mfsurvilo/MotorController-PCB/Version Updates.txt

Version Tracking

V5.0 -	Updated footprints, Reduced Mounting hole sizes
	Used io pins to ground the power indicator lights.
	Reduced pad size for AC in 
V5.1 - 7/24 
	Placed parts, deleted pin break to pins . 
	Routed alt pins from TRS jack into MCU for future iteration. 
	Decreased board size. Changed footprint of motor connector to have holes.  
	Started routing 
	
V5.2 - 8/10
	Moved a few parts.
	Updated the footprint on the 5V PS
	Rearranged text and resized it.
