mfsurvilo/MotorController-PCB/Motor Controller V.5.2.brd

## EAGLE design Motor Controller V.5.2.brd (2021-08-20)

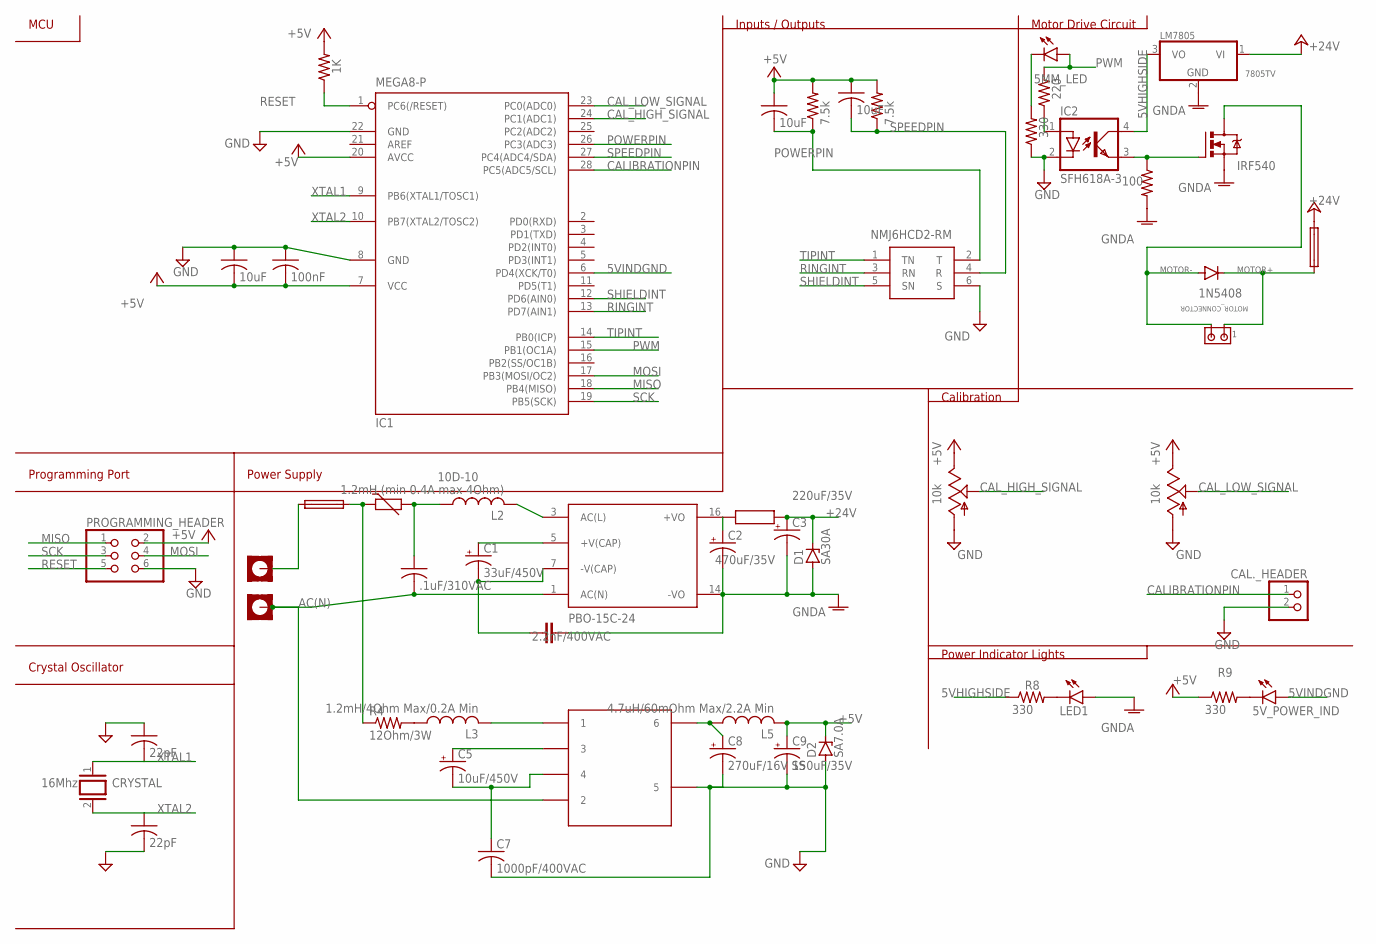
[picture p1: schematic Motor Controller V.5.2.sch]

Parts:
5V_POWER_IND: LED3MM
AC(N): PAD3.0; 3,0-PAD-SQUARE
C1: 33uF/450V; E5-13
C2: 470uF/35V; E5-10,5; MPN ECA1VHG471B
C3: 220uF/35V; E5-10,5; MPN A768KS227M1VLAE024
C4: .1uF/310VAC; C102-064X133
C5: 10uF/450V; E5-10,5
C6, C15: 22pF; C025-024X044
C7: 1000pF/400VAC; C075-052X106
C8: 270uF/16V SS; E2,5-6
C9: 150uF/35V; E3,5-8
C10, C12, C13: 10uF; C025-024X044
C14: 100nF; C025-024X044
CAL._HEADER: PINHD-1X2; 1X02
CRYSTAL: 16Mhz; QS
CY1: 2.2nF/400VAC; YC10B4
D1: SA30A; TVS-10
D2: SA7.0A; TVS-10
D3: 1N5408; DO201-15; MPN 1N5408-E3/54
F1: FUSESH22,5; SH22,5
F2: 1A/300V; SH22,5
FAST: 10k; CT6
H1: PAD3.0; 3,0-PAD-SQUARE
IC1: MEGA8-P; DIL28-3
IC2: SFH618A-3; DIP4
J1: NMJ6HCD2-RM; NMJ6HCD2RM
L2: 1.2mH (min 0.4A max 4Ohm); RCP1317_INDUCTOR
L3: 1.2mH/4Ohm Max/0.2A Min; RCP1317_INDUCTOR
L5: 4.7uH/60mOhm Max/2.2A Min; RLB0914_INDUCTOR
LED1: LED3MM
LM7805: 7805TV; TO220V
MOTOR_CONNECTOR: MATE-N-LOK_193839-1; MATE-N-LOK_2PIN_CONNECTOR
PROGRAMMING_HEADER: PINHD-2X3; 2X03
PS1: PBO-15C-24; CONV_PBO-15C-24
PWM_IND: 5MM_LED
Q1: IRF540; TO220BV
R1: 10D-10; R-7,5
R2: 1K; 0204/7
R3, R7: 7.5k; 0204/7
R4: 12Ohm/3W; VTA52
R5: 220; 0204/7
R6: 100; 0204/7
R8, R9, R10: 330; 0204/7
SLOW: 10k; CT6
U$1: L503-13B05R; LS03-13BO5R3
U$2: HCTI-22-16.4

Connections:
5VHIGHSIDE: IC2.4 (COL), LM7805.3 (VO), R8.1
5VINDGND: 5V_POWER_IND.A, IC1.6 (PD4(XCK/T0))
+5V: C9.+, C10.1, C12.1, C13.2, C14.2, D2.C, FAST.E, IC1.7 (VCC), IC1.20 (AVCC), L5.P$2 (2), PROGRAMMING_HEADER.2, R2.2, R3.2, R7.2, R9.1, SLOW.E
+24V: C3.+, D1.C, F1.2, LM7805.1 (VI), U$2.P$2
AC(L): L2.P$2 (2), PS1.3 (AC(L))
AC(N): AC(N).B3,0, C4.2, PS1.1 (AC(N)), U$1.3 (2), U$1.4 (2)
CALIBRATIONPIN: CAL._HEADER.1, IC1.28 (PC5(ADC5/SCL))
CAL_HIGH_SIGNAL: FAST.S, IC1.24 (PC1(ADC1))
CAL_LOW_SIGNAL: IC1.23 (PC0(ADC0)), SLOW.S
GND: C6.2, C7.2, C8.-, C9.-, C13.1, C14.1, C15.1, CAL._HEADER.2, D2.A, FAST.A, IC1.8 (GND), IC1.22 (GND), IC2.2 (C), J1.6 (S), PROGRAMMING_HEADER.6, R10.1, SLOW.A, U$1.9 (5), U$1.10 (5)
GNDA: C2.-, C3.-, CY1.1, D1.A, LED1.A, LM7805.2 (GND), PS1.14 (-VO), Q1.S, R6.2
MISO: IC1.18 (PB4(MISO)), PROGRAMMING_HEADER.1
MOSI: IC1.17 (PB3(MOSI/OC2)), PROGRAMMING_HEADER.4
MOTOR+: D3.C, F1.1, MOTOR_CONNECTOR.P$1 (1)
MOTOR-: D3.A, MOTOR_CONNECTOR.P$2 (2), Q1.D
unnamed: IC2.1 (A), R5.1
unnamed: IC2.3 (EMIT), Q1.G, R6.1
unnamed: LED1.K (C), R8.2
unnamed: C2.+, PS1.16 (+VO), U$2.P$1
unnamed: C1.+, PS1.5 (+V(CAP))
unnamed: C1.-, CY1.2, PS1.7 (-V(CAP))
unnamed: F2.2, H1.B3,0
unnamed: F2.1, R1.1, R4.1
unnamed: C4.1, L2.P$1 (1), R1.2
unnamed: 5V_POWER_IND.K (C), R9.2
unnamed: L3.P$1 (1), R4.2
unnamed: L3.P$2 (2), U$1.1, U$1.2 (1)
unnamed: C5.+, U$1.5 (3), U$1.6 (3)
unnamed: C5.-, C7.1, U$1.7 (4), U$1.8 (4)
unnamed: C8.+, L5.P$1 (1), U$1.11 (6), U$1.12 (6)
unnamed: PWM_IND.C, R10.2
POWERPIN: C10.2, IC1.26 (PC3(ADC3)), J1.2 (T), R3.1
PWM: IC1.15 (PB1(OC1A)), PWM_IND.A, R5.2
RESET: IC1.1 (PC6(/RESET)), PROGRAMMING_HEADER.5, R2.1
RINGINT: IC1.13 (PD7(AIN1)), J1.3 (RN)
SCK: IC1.19 (PB5(SCK)), PROGRAMMING_HEADER.3
SHIELDINT: IC1.12 (PD6(AIN0)), J1.5 (SN)
SPEEDPIN: C12.2, IC1.27 (PC4(ADC4/SDA)), J1.4 (R), R7.1
TIPINT: IC1.14 (PB0(ICP)), J1.1 (TN)
XTAL1: C15.2, CRYSTAL.1, IC1.9 (PB6(XTAL1/TOSC1))
XTAL2: C6.1, CRYSTAL.2, IC1.10 (PB7(XTAL2/TOSC2))

Notes on the sheet:
MCU
Motor Drive Circuit
Inputs / Outputs
Programming Port
Crystal Oscillator
Calibration
Power Supply
Power Indicator Lights

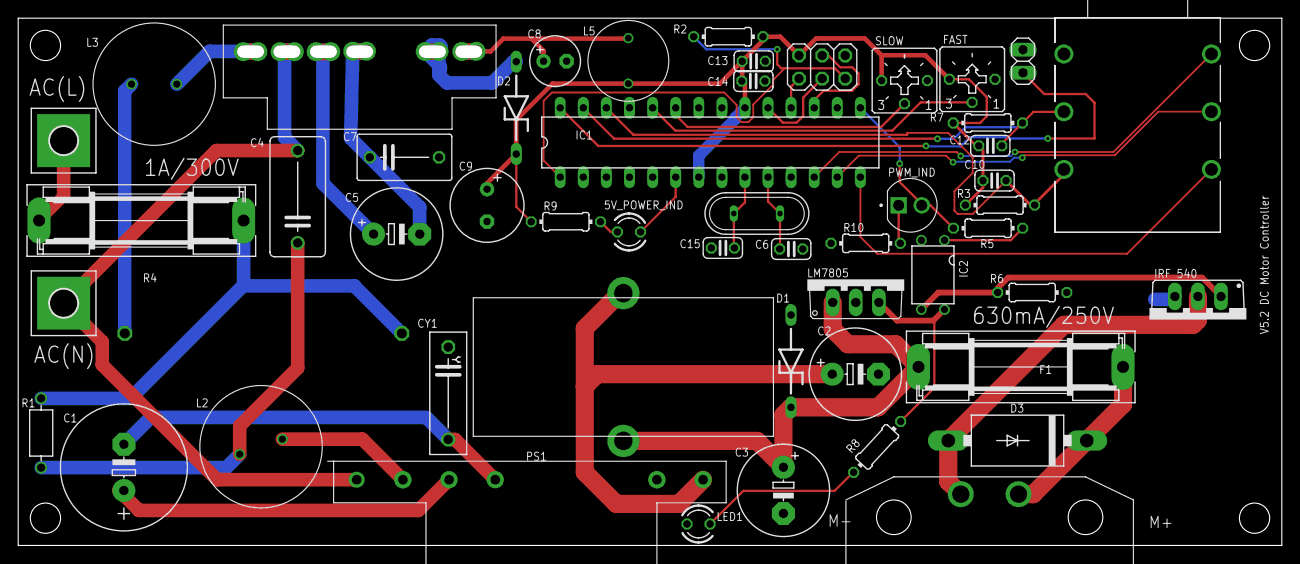
[picture p2: board Motor Controller V.5.2.brd from above]

Board: 2 copper layers, 139.0 x 58.0 mm, 52 parts (1 on the bottom side), 41 nets.
