mfsurvilo/MotorController-PCB/motor Controller4.brd

## EAGLE design motor Controller4.brd (2021-07-21)

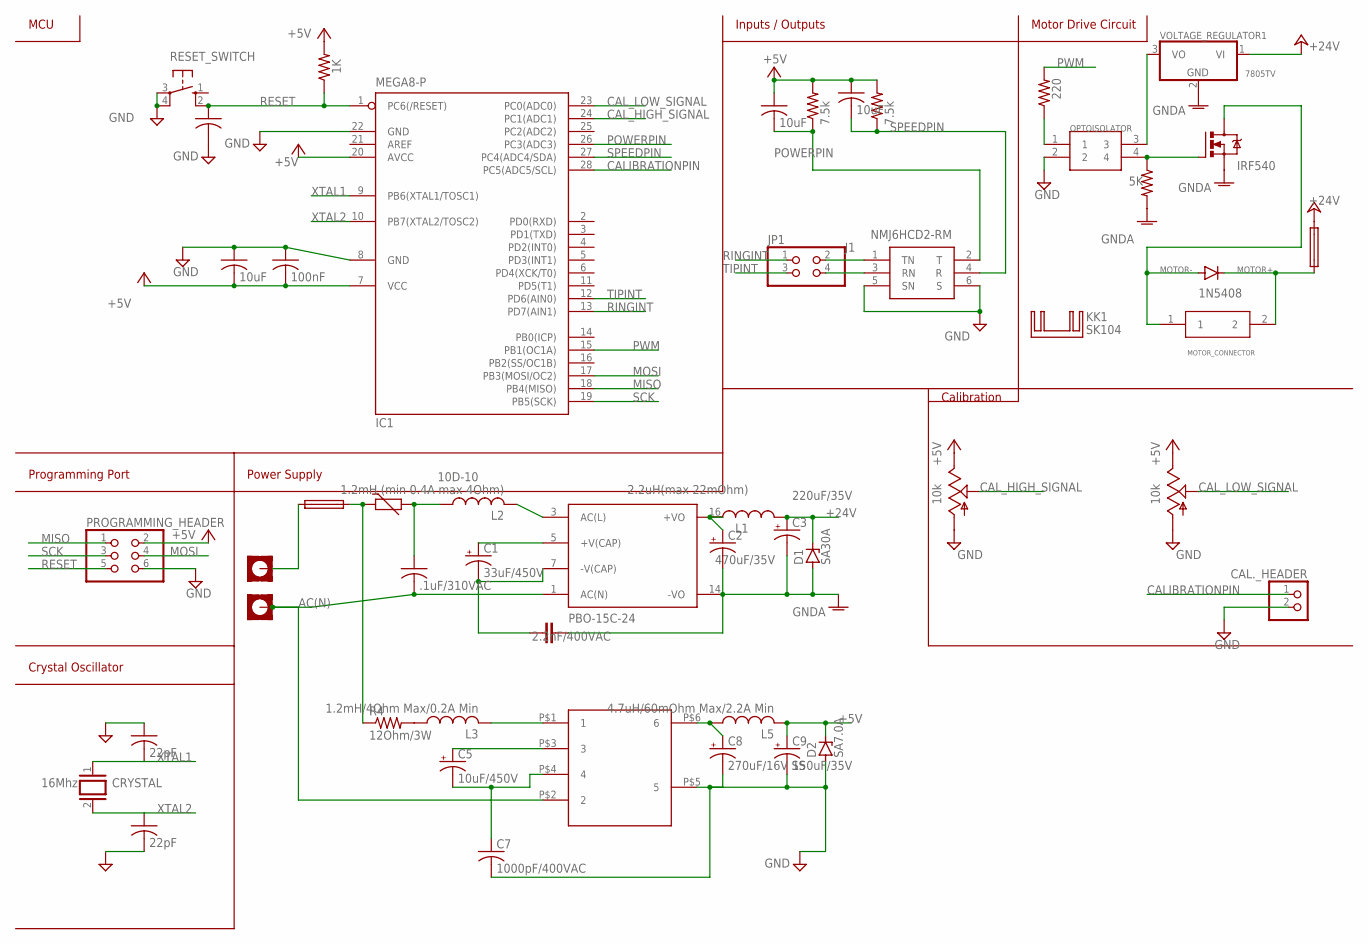
[picture p3: schematic motor Controller4.sch]

Parts:
1N5408: 1N5408; DO201-15; MPN 1N5408-E3/54
C1: 33uF/450V; E5-13
C2: 470uF/35V; E5-10,5; MPN ECA1VHG471B
C3: 220uF/35V; E5-10,5; MPN A768KS227M1VLAE024
C4: .1uF/310VAC; C150-091X182
C5: 10uF/450V; E5-10,5
C6, C15: 22pF; C025-024X044
C7: 1000pF/400VAC; C075-052X106
C8: 270uF/16V SS; E2,5-6
C9: 150uF/35V; E3,5-8
C10, C12, C13: 10uF; C025-024X044
C11: C-US025-024X044; C025-024X044
C14: 100nF; C025-024X044
CAL._HEADER: PINHD-1X2; 1X02
CRYSTAL: 16Mhz; QS
CY1: 2.2nF/400VAC; YC10B4
D1: SA30A; ZDIO-7.5
D2: SA7.0A; ZDIO-7.5
F1: FUSESH22,5; SH22,5
F2: 1A/300V; SH22,5
FAST: 10k; CT6
H1, H2: MOUNT-PAD-SQUARE3.6; 3,6-PAD-SQUARE
IC1: MEGA8-P; DIL28-3
J1: NMJ6HCD2-RM; NMJ6HCD2RM
JP1: PINHD-2X2; 2X02
KK1: SK104
L1: 2.2uH(max 22mOhm); TJ5-U1
L2: 1.2mH (min 0.4A max 4Ohm); 6000-XXXX-RC
L3: 1.2mH/4Ohm Max/0.2A Min; 6000-XXXX-RC
L5: 4.7uH/60mOhm Max/2.2A Min; 0207/2V
MOTOR_CONNECTOR: 641963-1; 641963-1_TYC
OPTOISOLATOR: SFH619A
PROGRAMMING_HEADER: PINHD-2X3; 2X03
PS1: PBO-15C-24; CONV_PBO-15C-24
Q1: IRF540; TO220BV
R1: 10D-10; R-7,5
R2: 1K; 0204/7
R3, R7: 7.5k; 0204/7
R4: 12Ohm/3W; 0617/22
R5: 220; 0204/7
R6: 5K; 0204/7
RESET_SWITCH: 10-XX; B3F-10XX
SLOW: 10k; CT6
U$1: L503-13B05R$3; LS03-13BO5R3
VOLTAGE_REGULATOR1: 7805TV; TO220V

Connections:
+5V: C9.+, C10.1, C12.1, C13.2, C14.2, D2.C, FAST.E, IC1.7 (VCC), IC1.20 (AVCC), L5.2, PROGRAMMING_HEADER.2, R2.2, R3.2, R7.2, SLOW.E
+24V: C3.+, D1.C, F1.2, L1.2, VOLTAGE_REGULATOR1.1 (VI)
AC(L): L2.2, PS1.3 (AC(L))
AC(N): C4.2, H2.B3,6, PS1.1 (AC(N)), U$1.P$2 (2)
CALIBRATIONPIN: CAL._HEADER.1, IC1.28 (PC5(ADC5/SCL))
CAL_HIGH_SIGNAL: FAST.S, IC1.24 (PC1(ADC1))
CAL_LOW_SIGNAL: IC1.23 (PC0(ADC0)), SLOW.S
GND: C6.2, C7.2, C8.-, C9.-, C11.2, C13.1, C14.1, C15.1, CAL._HEADER.2, D2.A, FAST.A, IC1.8 (GND), IC1.22 (GND), J1.5 (SN), J1.6 (S), OPTOISOLATOR.2, PROGRAMMING_HEADER.6, RESET_SWITCH.3, RESET_SWITCH.4 (P1), SLOW.A, U$1.P$5 (5)
GNDA: C2.-, C3.-, CY1.1, D1.A, PS1.14 (-VO), Q1.S, R6.2, VOLTAGE_REGULATOR1.2 (GND)
MISO: IC1.18 (PB4(MISO)), PROGRAMMING_HEADER.1
MOSI: IC1.17 (PB3(MOSI/OC2)), PROGRAMMING_HEADER.4
MOTOR+: 1N5408.C, F1.1, MOTOR_CONNECTOR.2
MOTOR-: 1N5408.A, MOTOR_CONNECTOR.1, Q1.D
unnamed: OPTOISOLATOR.1, R5.1
unnamed: OPTOISOLATOR.4, Q1.G, R6.1
unnamed: OPTOISOLATOR.3, VOLTAGE_REGULATOR1.3 (VO)
unnamed: C2.+, L1.1, PS1.16 (+VO)
unnamed: C1.+, PS1.5 (+V(CAP))
unnamed: C1.-, CY1.2, PS1.7 (-V(CAP))
unnamed: J1.1 (TN), JP1.2
unnamed: F2.2, H1.B3,6
unnamed: F2.1, R1.1, R4.1
unnamed: C4.1, L2.1, R1.2
unnamed: J1.3 (RN), JP1.4
unnamed: L3.1, R4.2
unnamed: L3.2, U$1.P$1 (1)
unnamed: C5.+, U$1.P$3 (3)
unnamed: C5.-, C7.1, U$1.P$4 (4)
unnamed: C8.+, L5.1, U$1.P$6 (6)
POWERPIN: C10.2, IC1.26 (PC3(ADC3)), J1.2 (T), R3.1
PWM: IC1.15 (PB1(OC1A)), R5.2
RESET: C11.1, IC1.1 (PC6(/RESET)), PROGRAMMING_HEADER.5, R2.1, RESET_SWITCH.2 (S1)
RINGINT: IC1.13 (PD7(AIN1)), JP1.1
SCK: IC1.19 (PB5(SCK)), PROGRAMMING_HEADER.3
SPEEDPIN: C12.2, IC1.27 (PC4(ADC4/SDA)), J1.4 (R), R7.1
TIPINT: IC1.12 (PD6(AIN0)), JP1.3
XTAL1: C15.2, CRYSTAL.1, IC1.9 (PB6(XTAL1/TOSC1))
XTAL2: C6.1, CRYSTAL.2, IC1.10 (PB7(XTAL2/TOSC2))

Notes on the sheet:
MCU
Motor Drive Circuit
Inputs / Outputs
Programming Port
Crystal Oscillator
Calibration
Power Supply

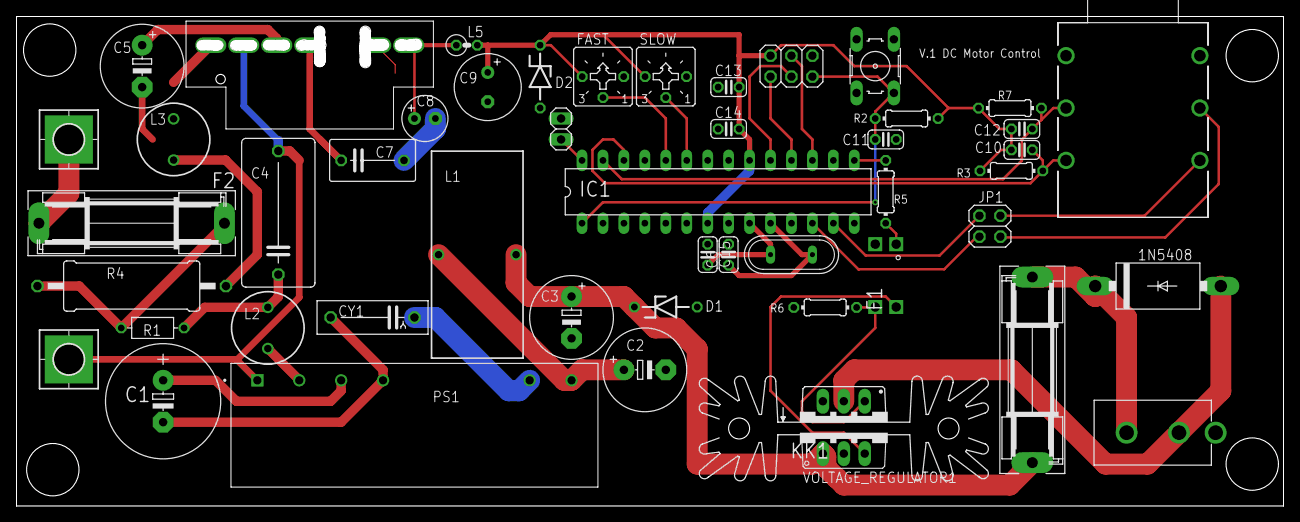
[picture p4: board motor Controller4.brd from above]

Board: 2 copper layers, 153.7 x 59.4 mm, 50 parts (0 on the bottom side), 38 nets.
