mfsurvilo/MotorController-PCB/(commit log)

2021-07-21 Ver.5 Prep for second print
    [MC4BOM.xlsx, Slot Test.brd, Slot Test.sch, motor Controller3.brd, motor Controller4.brd, motor Controller4.sch]
2021-07-21 Ver.5 All files added
    [MC4BOM.xlsx, Motor Controller V.5.brd, Motor Controller V.5.sch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]
2021-07-24 Starting to route on new board with updated components. v5.1
    [Motor Controller V.5.brd, Motor Controller V.5.sch]
2021-07-24 Start routing on new board with updated components v5.1
    [MC4BOM.xlsx, Motor Controller V.5.1.brd, Motor Controller V.5.1.sch]
2021-08-20 Add ver 5.2 board design
    [Motor Controller V.5.2.brd, Motor Controller V.5.2.sch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]
